Kenshin84/Dummy-Robot/4.Model/Cycloidal/Cycloid v21 original.step

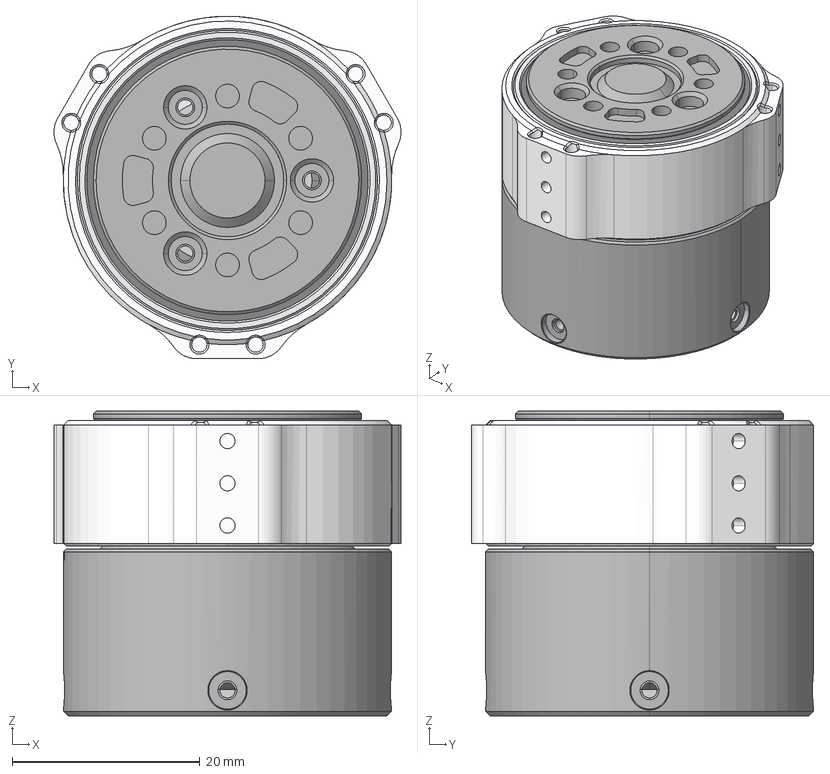
[picture p1: CAD file, 2026-11-12]
4.Model/Cycloidal/Cycloid v21 original.step
37.0 x 36.5 x 32.5 mm
下盖
上盖
电机连接盘
定子
转子
偏心轴
零部件33
零部件35
零部件36
摆线碟2
摆线碟1
电机 v2
轴承-4x7x2.5 v1 x 13
轴承-7x10x3 v1 x 2
轴承-25x32x4 v2 x 2
