Kenshin84/Dummy-Robot/4.Model/Cycloidal/cyloidal v21.SLDASM

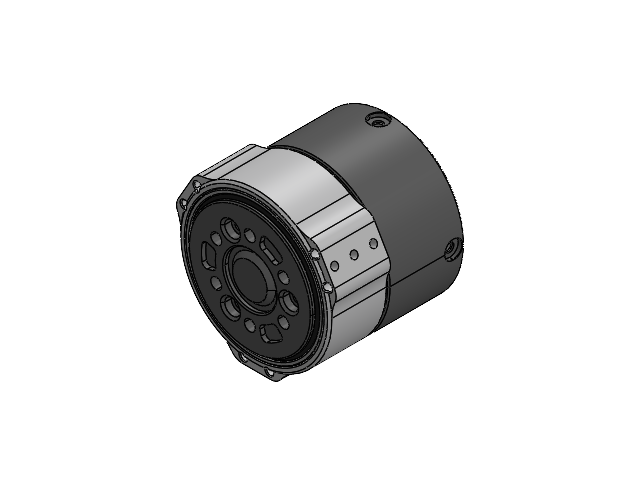
[picture p2: CAD file, 2026-11-12]
4.Model/Cycloidal/cyloidal v21.SLDASM
零部件33.step
零部件35.step
零部件36.step
轴承-4x7x2.5 v1.step x 13
轴承-7x10x3 v1.step x 2
轴承-25x32x4 v2.step x 2
下盖.step
上盖.step
电机连接盘.step
定子.step
转子.step
偏心轴.step
摆线碟2.step
摆线碟1.step
电机 v2.step
