Kenshin84/Dummy-Robot/2.Firmware/Ctrl-Step-Driver-STM32F1-fw/README.ca.md

# Firmware Ctrl-Step (STM32F1)

[Llegiu el README original en xinès](README.md).

Després de regenerar el projecte amb STM32CubeMX, cal revertir els canvis a `stm32f1xx_it.c`.
