Kenshin84/Dummy-Robot/2.Firmware/Ctrl-Step-Driver-STM32F1-fw/Ctrl/Sensor/Encoder/mt6816_base.cpp

#include "mt6816_base.h"

bool MT6816Base::Init()
{
    SpiInit();
    UpdateAngle();

    // Check if the stored calibration data are valid
    angleData.rectifyValid = true;
    for (uint32_t i = 0; i < RESOLUTION; i++)
    {
        if (quickCaliDataPtr[i] == 0xFFFF)
            angleData.rectifyValid = false;
    }

    return angleData.rectifyValid;
}


uint16_t MT6816Base::UpdateAngle()
{
    dataTx[0] = (0x80 | 0x03) << 8;
    dataTx[1] = (0x80 | 0x04) << 8;

    for (uint8_t i = 0; i < 3; i++)
    {
        dataRx[0] = SpiTransmitAndRead16Bits(dataTx[0]);
        dataRx[1] = SpiTransmitAndRead16Bits(dataTx[1]);

        spiRawData.rawData = ((dataRx[0] & 0x00FF) << 8) | (dataRx[1] & 0x00FF);

        //Comprova la paritat
        hCount = 0;
        for (uint8_t j = 0; j < 16; j++)
        {
            if (spiRawData.rawData & (0x0001 << j))
                hCount++;
        }
        if (hCount & 0x01)
        {
            spiRawData.checksumFlag = false;
        } else
        {
            spiRawData.checksumFlag = true;
            break;
        }
    }

    if (spiRawData.checksumFlag)
    {
        spiRawData.rawAngle = spiRawData.rawData >> 2;
        spiRawData.noMagFlag = (bool) (spiRawData.rawData & (0x0001 << 1));
    }

    angleData.rawAngle = spiRawData.rawAngle;
    angleData.rectifiedAngle = quickCaliDataPtr[angleData.rawAngle];

    return angleData.rectifiedAngle;
}


bool MT6816Base::IsCalibrated()
{
    return angleData.rectifyValid;
}
