Kenshin84/Dummy-Robot/(commit log)

2026-11-12 Afegeix la traducció catalana del README
2026-11-12 Tradueix al català la nota de regeneració de Ctrl-Step
2026-11-12 Conserva el README original en xinès
2026-11-12 Mostra el README en català a la portada
2026-11-12 Afegeix els enllaços de compra de motors i reductors
2026-11-12 Tradueix íntegrament l’única línia del README Ctrl-Step (blob 5f67a37)
2026-11-12 Afegeix la documentació catalana del reductor cicloïdal
2026-11-12 Enllaça la guia catalana del reductor cicloïdal
2026-11-12 Tradueix els comentaris de la memòria flaix al català
2026-11-12 Afegeix una referència de compra per al motor brushless 2204
2026-11-12 Publica el muntatge cicloïdal v21 i documenta la tria del 2204
    [Cycloid v21 original.step, cyloidal v21.SLDASM]
2026-11-12 Corregeix la compatibilitat del SunnySky amb el cicloïdal v21
2026-11-13 Publica la llista de compra amb preus i comprovacions pendents
2026-11-13 Enllaça la llista de compra des de la portada
2026-11-13 Afegeix alternatives Amazon i AliExpress i calcula el pressupost aproximat
2026-11-13 Afegeix anuncis directes AliExpress i recalcula el pressupost
2026-11-13 Separa el muntatge original i les alternatives de compra
2026-11-13 Canvia la transmissió a GT2 i documenta les cotes de compra
2026-11-13 Actualitza les cotes GT2 a forat de 5 mm i corretja de 4 mm
2026-11-13 Aclareix la cota de 4 mm mesurada a SolidWorks
2026-11-13 Afegeix el conjunt UMOT 51:1 com a alternativa per al J6
